mvanocht/Ping-Pong-Catcher/Visio-Ping Pong Ball Catcher Software Requirements Specification.pdf

Software Requirements Specification | October 23, 2024

## YES

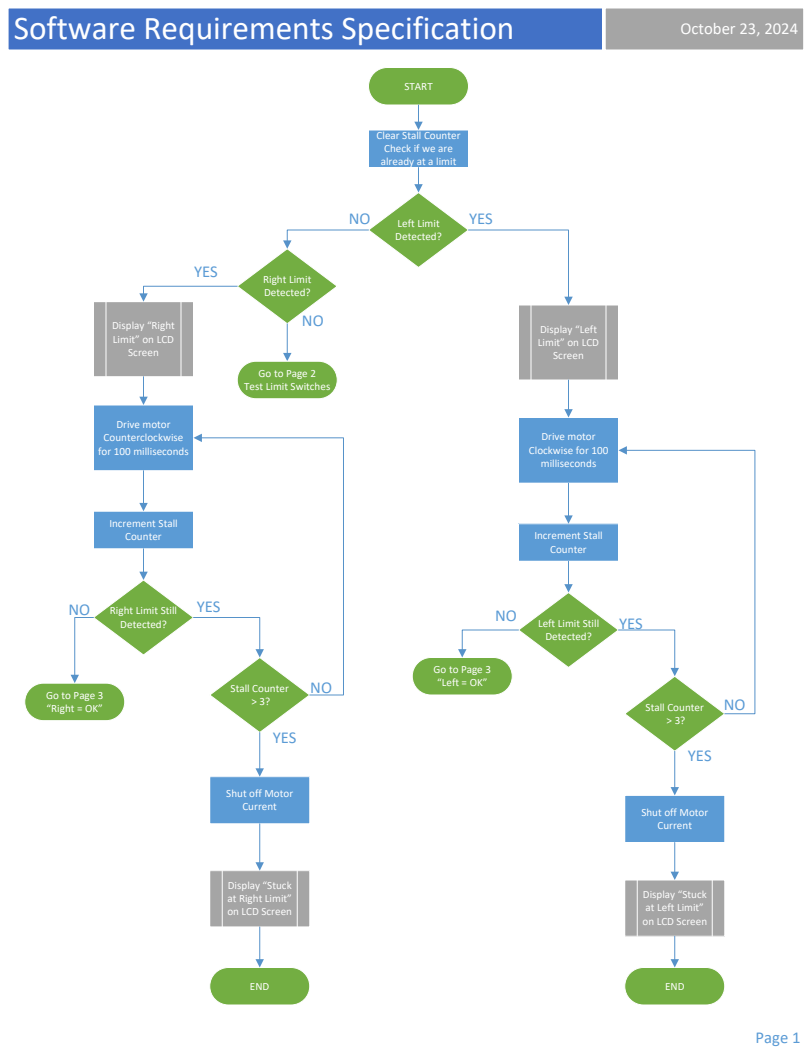
[picture p7: page 1]
START; Left Limit Detected?; Drive motor Clockwise for 100 milliseconds; YES; Increment Stall Counter; Stall Counter > 3?; END; Right Limit Detected?; Drive motor Counterclockwise for 100 milliseconds

Clear Stall Counter
Check if we are
already at a limit

Display “Right
Limit” on LCD
Screen

Display “Left

Go to Page 2
Test Limit Switches

Right Limit Still
Detected?

Left Limit Still

Go to Page 3
“Left = OK”

“Right = OK”

Shut off Motor
Current

Display “Stuck
at Right Limit”
on LCD Screen

at Left Limit”

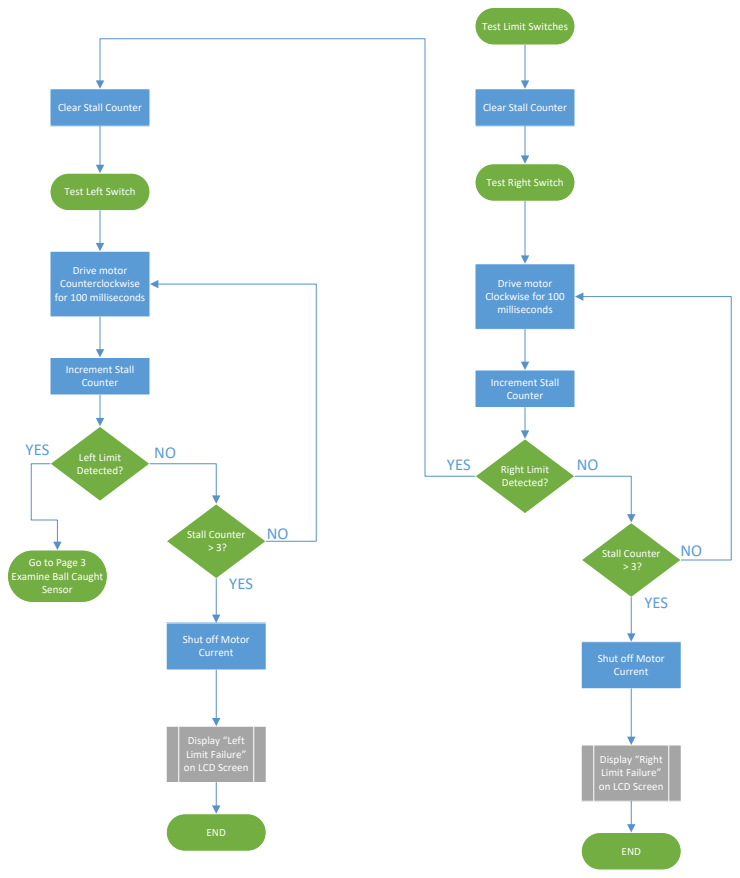
[picture p8: page 2]
Drive motor Clockwise for 100 milliseconds; Right Limit Detected?; Increment Stall Counter; Stall Counter > 3?; YES; END; Drive motor Counterclockwise for 100 milliseconds; Left Limit Detected?; Clear Stall Counter

Test Limit Switches

Test Right Switch Test Left Switch

Go to Page 3
Examine Ball Caught
Sensor

Shut off Motor
Current

Display “Left
Limit Failure”
on LCD Screen

Display “Right

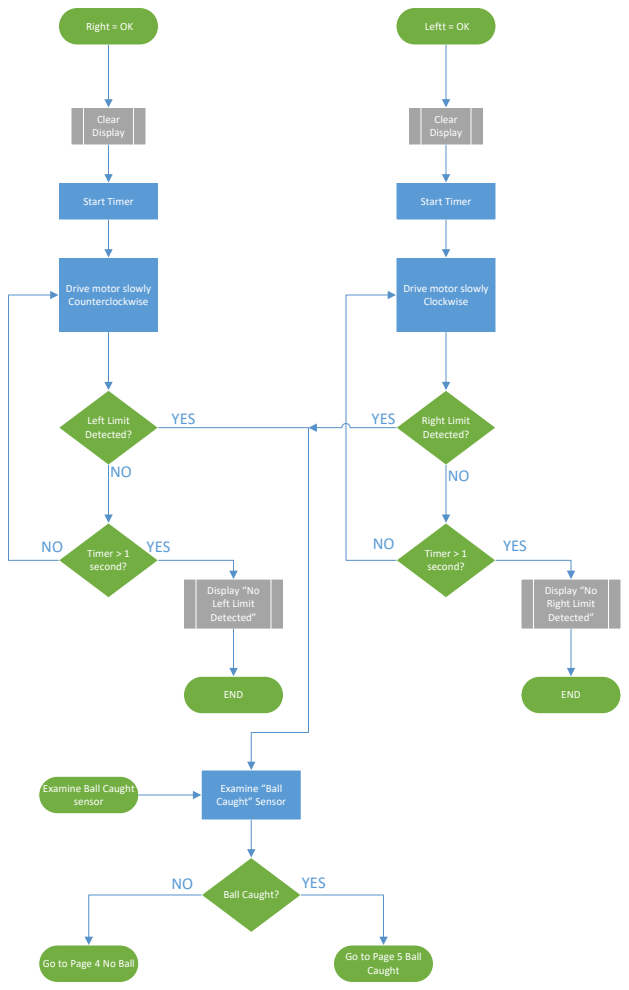
[picture p9: page 3]
Right = OK; Leftt = OK; Clear Display; Start Timer; Left Limit Detected?; Timer > 1 second?; YES; END; Display “No Left Limit Detected”; Right Limit Detected?; Display “No Right Limit Detected”; Examine “Ball Caught” Sensor; Ball Caught?; Go to Page 4 No Ball; Go to Page 5 Ball; Caught

Drive motor slowly
Counterclockwise

Clockwise

Examine Ball Caught
sensor

YES | NO

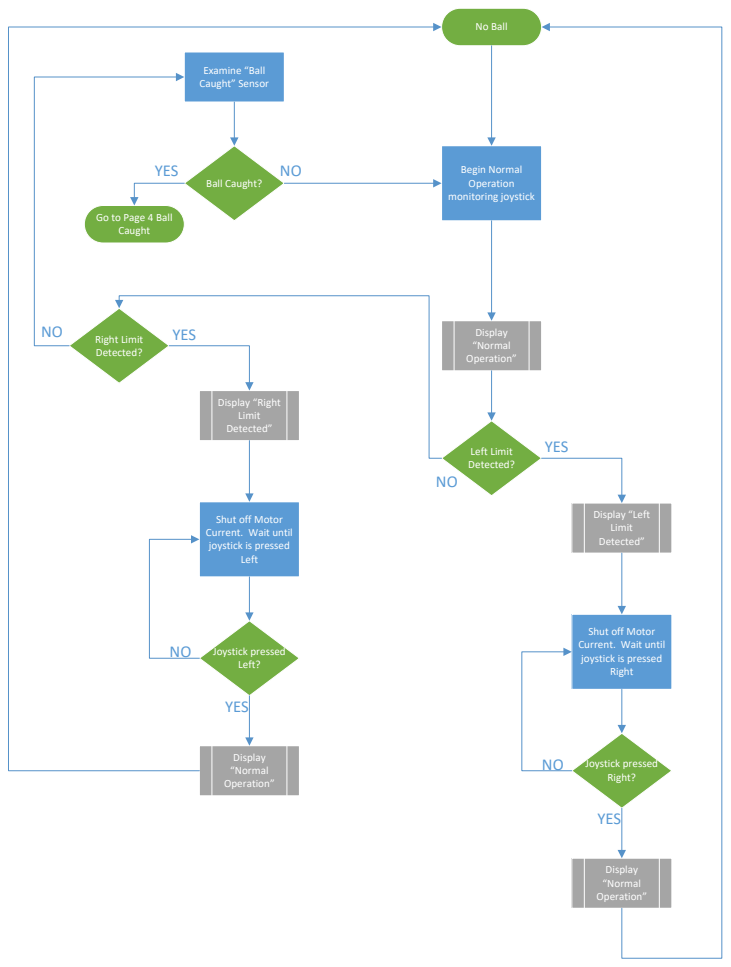
[picture p10: page 4]
No Ball; Begin Normal Operation monitoring joystick; Display “Normal Operation”; Left Limit Detected?; Joystick pressed Right?; Display “Left Limit Detected”; YES; Right Limit Detected?; Joystick pressed Left?; Display “Right Limit Detected”; Examine “Ball Caught” Sensor; Ball Caught?

Go to Page 4 Ball
Caught

Shut off Motor
Current. Wait until
joystick is pressed
Left

Right

Display “Normal

Operation”

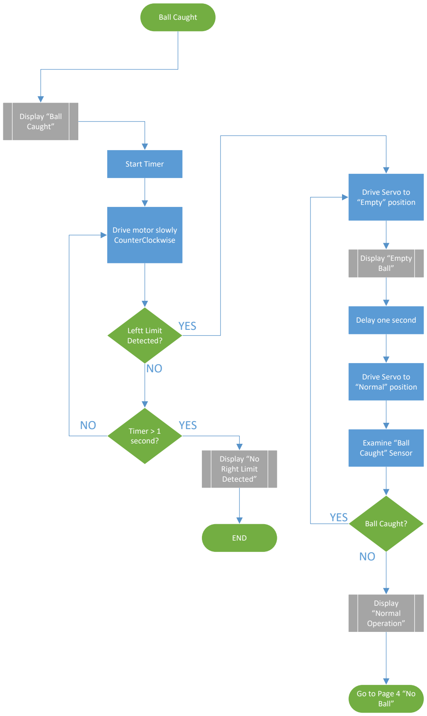
[picture p11: figure]
Ball Caught; Display “Ball Caught”; Drive motor slowly CounterClockwise; Start Timer; Leftt Limit Detected?; Timer > 1 second?; END; Display “No Right Limit Detected”; YES; Drive Servo to “Empty” position; Delay one second; Drive Servo to “Normal” position; Display “Empty Ball”; Display “Normal Operation”; Examine “Ball Caught” Sensor; Ball Caught? YES; Go to Page 4 “No Ball”
