mvanocht/Ping-Pong-Catcher/Pneumatic System.pdf

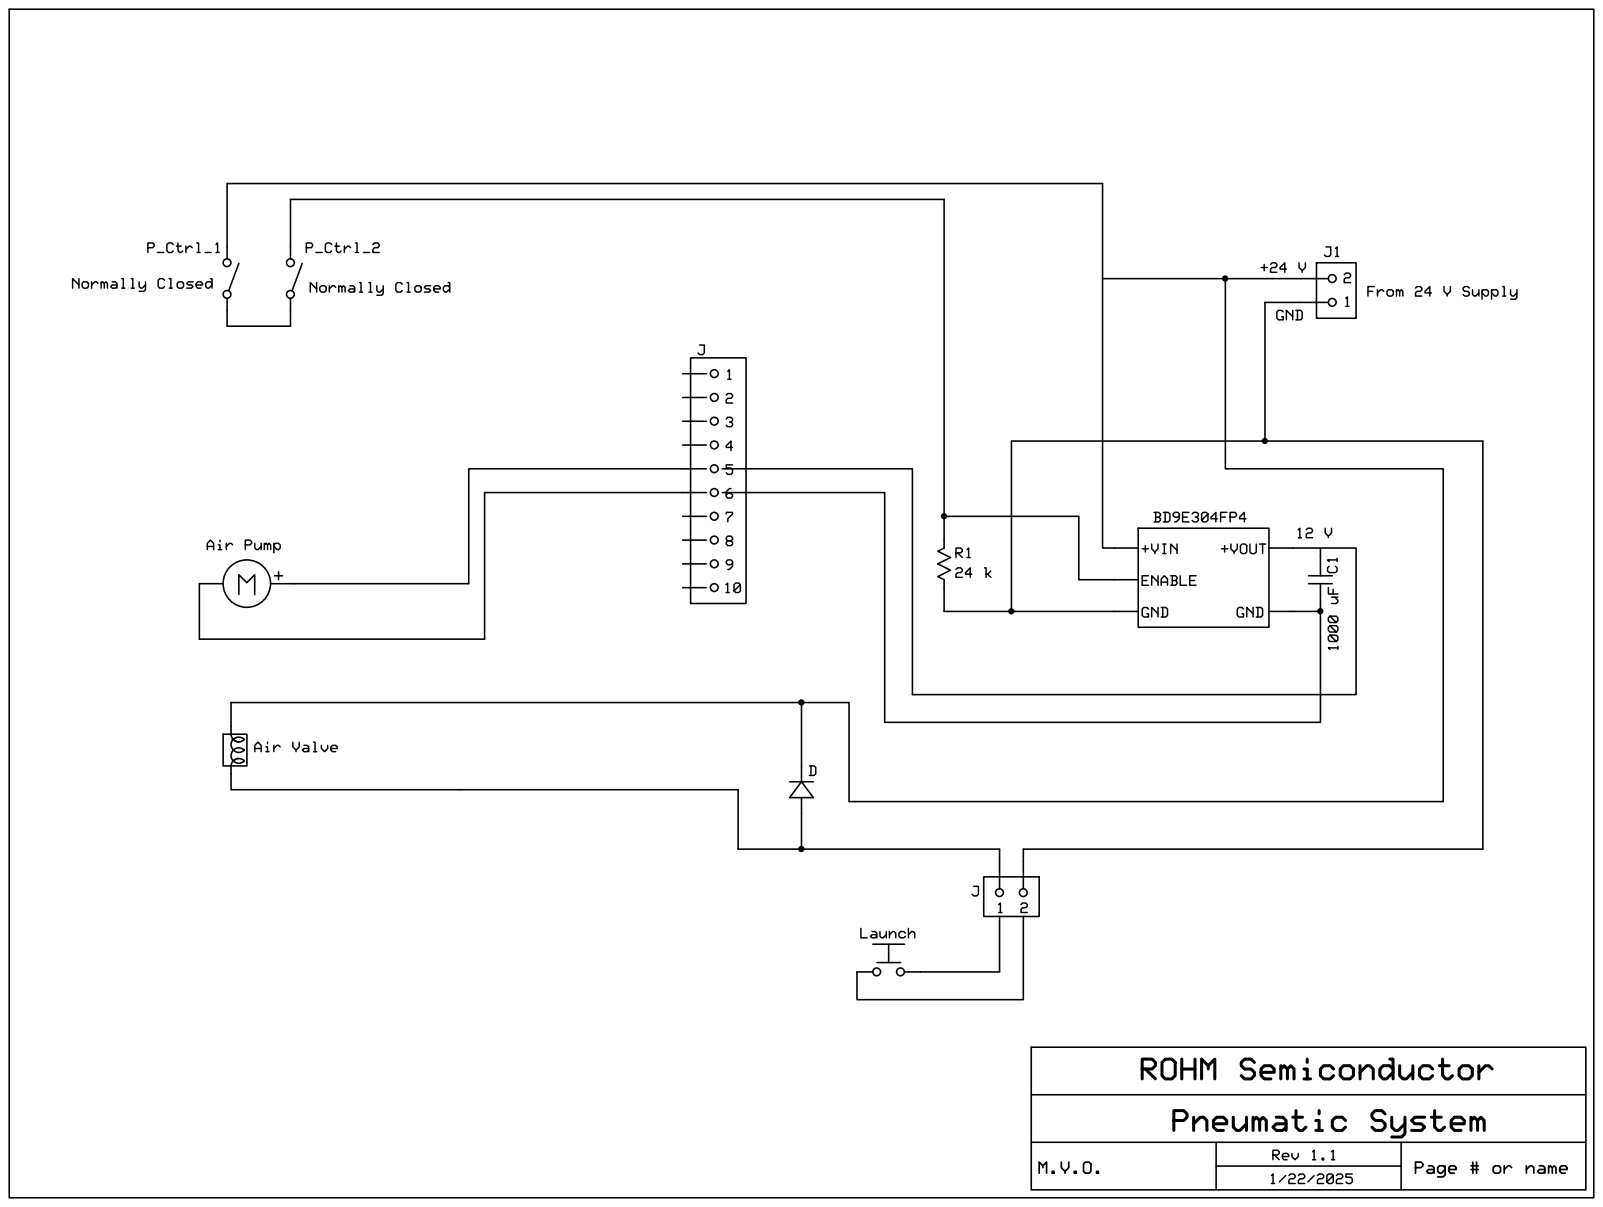
[picture p12: page 1]
