mvanocht/Ping-Pong-Catcher/(commit log)

2024-10-28 Version with brake and counts
2024-10-28 Update PingPongCathcher_Diagram.pptx
    updated to include pin 10 for servo drive
2024-10-30 Update Plinko_basic_catchcount_servo.ino
    Cleanup servo tipping operation. Now at the right limit is when ball will be tipped out.
2024-10-31 Update PingPongCathcher_Diagram.pptx
    update with pages to show Protoshield connections and dip switches for "limit simulation"
2024-11-13 test version to fix servo jitter
2024-11-27 TEST version include 1s OPTO debounce and servo jitter fix
2024-11-29 Fixed OPTO 1 second debouce
    [Plinko_basic_catchcount_servo.ino]
2024-12-02 "servo.ino" updated limit polarity (H=hit, L=not hit)
2024-12-02 Fixed Debounce to be correct and Limit switch polarity H=hit, L=not hit
    [Plinko_basic_catchcount_servo.ino]
2024-12-02 Fixed Debouncing, and Limit switch H=hit, L=not-hit
    [Plinko_basic_catchcount_servo.ino]
